SCPXASH/ArcGuard/presentation/assets/college_header.jpg

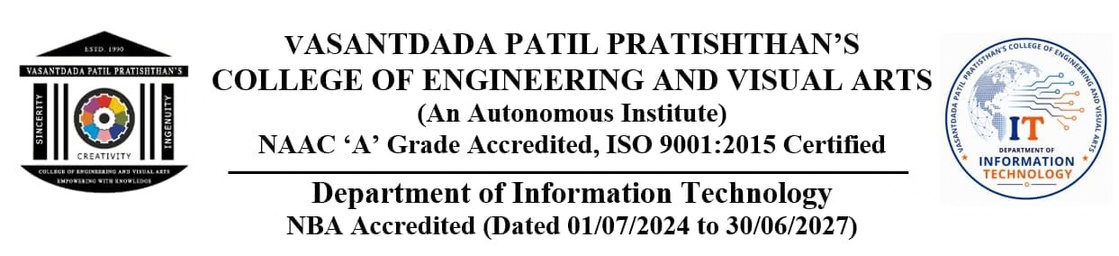
presentation/assets/college_header.jpg
