SCPXASH/ArcGuard/docs/diagrams/png/fig_one_sensor_test.png

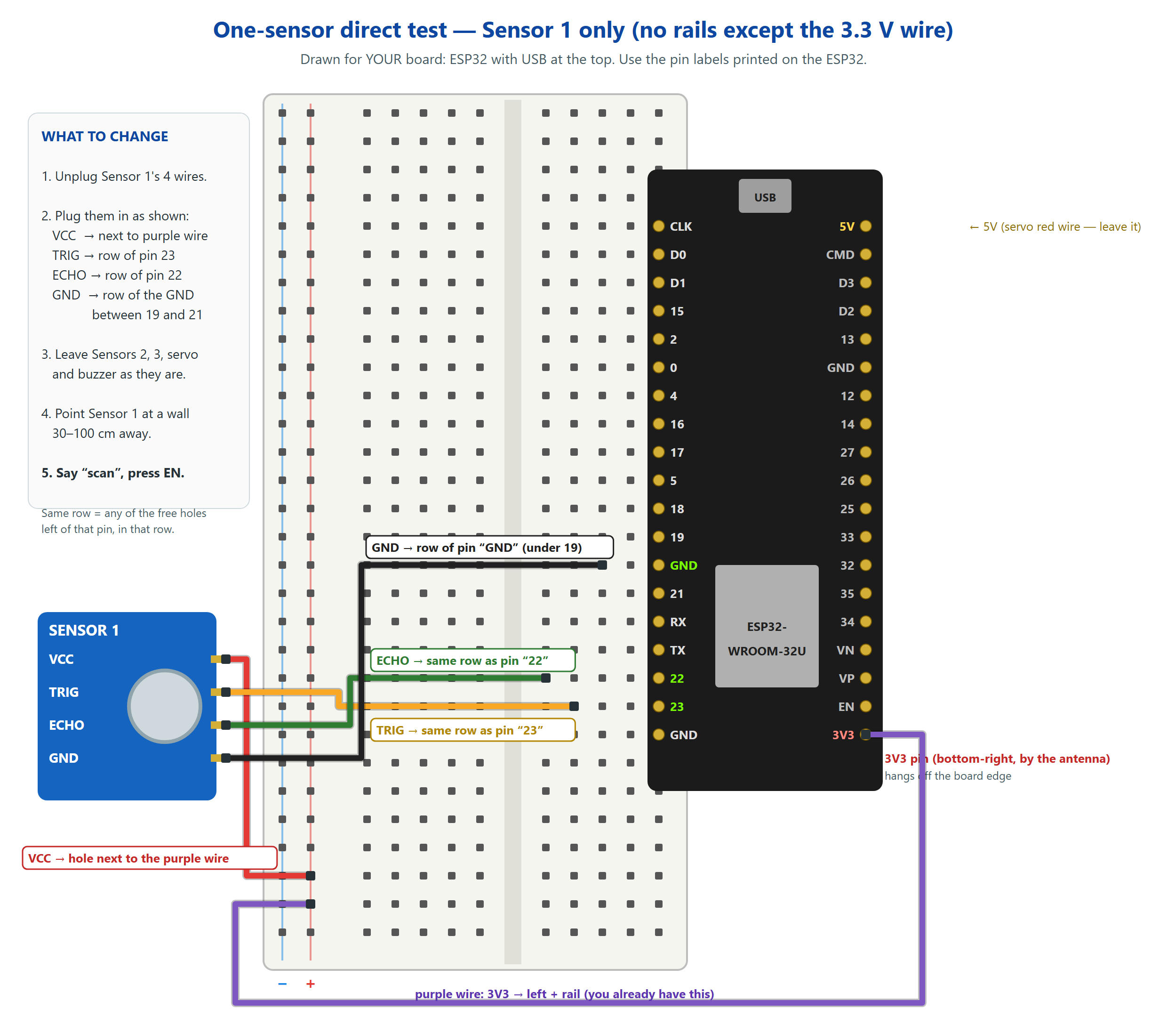
docs/diagrams/png/fig_one_sensor_test.png
