SCPXASH/ArcGuard/(commit log)

2026-11-03 Add Android app for the dashboard
    - android/: WebView app (com.arcguard.app) that loads the live dashboard
    from the backend, with a connect screen (USB via adb reverse or Wi-Fi),
    auto-retry, CSV downloads, and vibration/notifications on events
    - android/build.ps1: builds and optionally installs the APK using the
    Android SDK tools only (no Gradle)
    - dashboard: native event hook, "App" header button inside the app,
    phone-width header/toast layout
    - README: Android app section
2026-11-03 Add Android app to the project report
    - New Section 5.4 "Android Mobile App" with Fig 5.2 (real phone
    screenshots; ESP32 not connected, event totals cropped out)
    - Test plan (now 5.5) gains a phone-alert test with Observed left blank
    - Abstract, objectives, architecture, software stack, future scope,
    list of figures and references updated; section references renumbered
    - Rebuilt DOCX and PDF
2026-11-03 Report: online app screenshots; phone layout fixes
    - Figs 5.2-5.3: new screenshots of the Android app with everything online
    (connect, overview, room map, analytics, event log, settings), driven by
    simulator.py and labelled as simulated data in captions and text
    - Room map: fewer distance-ring labels and no rear angle labels under the
    fixed-sensor labels on narrow screens (they overlapped on phones)
    - Event log: hide ID and Date columns at phone width so Category/Type show
    - README: how to demo the app without hardware
    [build_report.py]
2026-11-03 Add updated project presentation (16 slides)
    - presentation/ArcGuard_Presentation.pptx in the original deck's format,
    same 16 slides and titles, content updated to the current build
    (hardware + pin map, detection logic, backend, Android app)
    - presentation/build_ppt.py regenerates it (python-pptx)
